rin67630/Sound-pressure-level-meter-Booster/1_VersionHistory.md

01.05.2022   Update following the breaking changes of ESP8266 compiler:
             BREAKING: Upgrade to upstream newlib 4.0.0 release (64 bits time_t) (#7708)
             BREAKING: httpclient: remove deprecated API (#7617)
