rin67630/Sound-pressure-level-meter-Booster/(threads)

Thread 1 (2025-02-23):

Fragen zum Projekt und Fehler beim kompilieren

vipersiytyseven, 2025-02-23:
Hallo.
Ich bin auf der Suche nach einer Möglichkeit Daten meines dB Messgeräts abzuspeichern und zu visualisieren und bin auf Ihre Webseite aufmerksam geworden.
Sehr umfangreich und auch sehr beeindruckend das Sie einem handeslüblichen dB Messgerät Daten entlocken können.
Mir würde es zwar in erster Linie reichen die Daten im lokalen Netz abzuspeichern und auszuwerten, aber ich sehe mir gerne mal die Möglichkeiten Ihrer Software an.

Entschuldigen Sie bitte meine geringen Kenntnisse in der Programmierung.
Trotz Ihrer sehr umfangreichen Dokumentation, werde ich leider nicht ganz schlau mit den Einstellungen und dem Kompilieren der Software.

Beispiel: Seite 20 des deutschsprachigen Dokuments.
Hier steht irgendetwas von A0 Parameter und Credentials.h
Die Credentials.h sieht ganz anders aus als in Ihrem Beispiel und eine A0 Parameter Registrierkarte kann ich auch nicht finden.

oder auch hier
zwei gleiche Einträge und welche Funktion hat der Raspberry Pi ?

#define UDP_TARGET          "192.168.?.?"         // Destination IP for your own Raspberry Pi
#define UDP_TARGET           "192.168.001.001"    // Destination IP for Raspberry Pi (enter real local IP)

Ein weiteres Beispiel: Das Kompilieren hat bei mir ebenfalls nicht funktioniert.
Ich bekomme eine Fehler:
Compilation error: 'GMT_OFFSET_SEC' was not declared in this scope
Ich verwende Arduino Version 2.3.4

Leider habe ich hier in github auch keine Möglichkeit gefunden direkt mit Ihnen Kontakt aufzunehmen. Das würde vieles einfacher mache. Gibt es da eine Möglichkeit ?

Für Ihre Rückmeldung herzlichen Dank im Voraus.

rin67630, 2025-03-30:
Es tut mir Leid, dass ich nicht geantwortet habe.
Ich habe einen Familienereignis und musste meine Projekte für eine Weile vernachlässigen.
Ich bin z.Zt  in Spanien.
Es gibt sehr viele Einstellungen im Projekt, die man nur in speziellen Situationen benötigt. UDP-Target ist eins davon...
Wenn es nicht besonders eilig ist (2-3 Monaten) kann ich eine Version aufbereiten, die man nicht kompilieren muss.
Es reicht dann einen Python Skript auszuführen, der die Anwenderdaten abfragt.

Was haben Sie als Messgerät, was möchten Sie programmieren?

vipersiytyseven, 2025-03-30:
Hallo und herzlichen Dank für Ihre freundliche Rückmeldung.

Zum Messgerät:
Ich besitze ein GM1358. Allerdings ist das Layout der Platine gegenüber den Bildern in Ihrer Dokumentation etwas geändert.
Der Anschluss eines ESP war aber problemlos möglich. Den ESP habe ich aktuell im Batteriefach untergebracht da ich in das Hauptgehäuse für die Tests kein Loch fräsen wollte. Es passt erstaunlich gut da rein. Ich überlege gerade, es dort zu belassen und den usb-Anschluß über einen angepassten Deckel rauszuführen.

Zum Test ob Daten vom Messgerät an den ESP übertragen werden bin ich in der Zwischenzeit einen kleinen Schritt weitergekommen. Ich habe ein kleines Skript gefunden, dass mir die Daten ausliest und auf einer vom ESP bereitgestellten Webseite ausgibt.
Die Werte entsprechen natürlich nicht den eigentlichen gemessenen Werten. Kommen denen aber recht nahe.
Somit scheint erstmal die Funktion der Übertragung von Daten zu funktionieren.

Zur Frage: Was möchte ich programmieren ?
Mein eigentliches Vorhaben war nicht die dauerhafte Messung sondern eine gezielte mobile Messung die sich auch über mehrere Stunden hinziehen kann. Die empfangenen Daten  sollten auch nicht online abgelegt werden sondern nur lokal ohne Zugriff aufs Internet z.B.  eine Netzwerkfreigabe oder offline z.B. an einem direkt angeschlossenem Raspberry Pi oder eine angeschlossene SD Karte.

Für die abgelegten Daten würde mir ein einfaches kommasepariertes Textformat (csv) reichen das in gewissen Zeitabständen die empfangenen Daten abspeichert. Diese können dann nach Beendigung der Messung ausgewertet , bzw. mit entsprechenden Tools in eine grafische Darstellung umgewandelt werden.

Beispiel für csv Format.
30.00,A,slow,2025-01-26 13:39:33
31.00,A,slow,2025-01-26 13:39:34

Soviel zu meinem eigentlichen Wunschgedanken.

Vielleicht ist dieses aber mit Ihrer Software möglich oder kann  entsprechend erweitert werden und ist sicherlich für den ein oder anderen Anwender Ihrer Software nützlich wenn dadurch keine externen Anbieter benötigt werden und es sich nur um mobile Messungen handelt.

Ich probiere natürlich gerne die kompilierte Version aus.

Viele Grüße und noch einen schönen Aufenthalt in Spanien.

rin67630, 2025-03-31:
Hallo,
mit der Config.h am Ende der Nachricht solltest Du eine Variante kompilieren, die die Ergebnisse auf der serielle Schnittstelle ausgibt.
Wenn UDP_IS_NONE, brauchst du die UDP Addresse und -Port nicht
Genauso wenn COM_IS_NONE...

Ersetzt Du TERM_IS_SERIAL  durch TERM_IS_TELNET, wird beim booten die Adresse des ESP-Geräts gemeldet.
Du kannst danach das ESP-Gerät über Telnet ansprechen, viel praktischer, als über serielle Schnittstelle.
Toi-Toi...

-----------------

Config.h
#define SCREEN_IS_NONE
#define SCREEN_IS_REVERSED    // _IS_NORMAL, _IS_REVERSED To turn the display 180° if required
#define BRIGHTNESS           128  // PWM value for default brightness with TTGO 0=totally dark;255=totally shiny

//----------------------- SOFTWARE OPTIONS ---------------------------------
#define DASHBRD_IS_NONE    // _NONE , _THINGER          // (Internet Dashboard)
#define GRACE_PAUSE           //Suspend Thinger processing for a grace pause, if the remote server takes too long to react, in order to keep being reactive on menues
//#define STREAM_DATA         //Stream data to Thinger (instead of letting Thinger fetch the data when viewed)
#define TERM_IS_SERIAL        // _TELNET, _SERIAL  defines where do Menus and Reports occur)
#define UDP_IS_NONE           // _NONE , _SEND , _RECEIVE  // (UDP Inter-ESP Communication)
#define ESP_UDP_ADDR         "192.168.188.12"              // (IP of the receiving ESP having BATTERY_SOURCE_IS_UDP)
#define ESP_UDP_PORT         4200                          // (Port used to send/receive Values to other ESP)
#define COM_IS_NONE          // _NONE , _HOURLY , _DAILY   // Periodical reports to computer
#define COM_UDP_ADDR         "192.168.188.12"              // (IP of the receiving computer for night reports)
#define COM_UDP_PORT         4230                          // (Port used to send/receive Values to other computer)
#define METER_TYPE           2                             // SPL Types = None (0), AK_Modulbus (1), GM1358 (2), Gravity (3), ZTS_ZS (4), reserve, reserve, Calibration (7)

//----------------------- MEASUREMENT AND I/O OPTIONS---------------------------------
#define WEATHER_SOURCE_IS_NONE   //_OWM _NONE _BME680             Change end accordingly
#define BATTERY_SOURCE_IS_NONE   // _UDP _NONE                    Change end accordingly
#define SOUND_SOURCE_IS_A0       //_A0 _URL _UDP _NONE _FOO _MODBUS     Change end accordingly
#define SP_METER_IS_GM1358       // _AK_MODULBUS, GM1358, _GRAVITY, _ZTS_ZS  Defined in Credentials

//   === Telnet communication
#define WIFI_REPEAT          500    //mS for retries and LED blinking during WiFi initialization
#define WIFI_MAXTRIES        30
#define WIFI_POWER           15     // from 0.5 to 21.5 full power (more current draw)
#define NTP_DELAY            6000
#define GRACE_PAUSE                //Suspend Network processing for a grace pause, if the remote server takes too long to react, in order to keep being reactive on menues

//   === Serial communication
#define SERIAL_SPEED            9600     //9600  115200 230400

// *** Default Personalization ***
#if __has_include("Credentials.h")
#include "Credentials.h"
#else  // Placeholders credentials to be used with https://github.com/rin67630/ESP_Binary_patcher
  #define DEVICE_NAME            "DEVCNAME                "  // Device name in local network and at thinger.io
  #define WIFI_SSID              "WIFISSID                "
  #define WIFI_PASS              "WIFIPASS                "
  #define SERVICE_PROVIDER       "CLOUDNAM                "  // http:// console.thinger.io
  #define CLOUD_USERNAME         "DEVCUSER                "  // User at thinger.io
  #define DEVICE_CREDENTIALS     "DEVCCRED                "  // Device credentials at thinger.io
  #define TZ_OFF                 "TZ_OFF  "                  // Offset to GMT in secs (exactly 8  chars incl spaces)
  #define DST_OFF                "DST_OFF "                  // Summer Offset in secs (exactly 8  chars incl spaces)
  #define LONGTD                 "LONGTD  "                  // Longitude             (exactly 8  chars incl spaces)
  #define LATITD                 "LATITD  "                  // Latitude              (exactly 8  chars incl spaces)
  #define OWMAPI         "OWMAPI                          "  // (exactly 32 chars incl spaces)

  // ***Event parameters***
  #define  WIND_LIMIT                  15 // upper limit of Wind speed to record NATs
  #define  UPPER_LIMIT_DB              88 // upper limit of Thinger plots
  #define  LOWER_LIMIT_DB              31 // lower limit of Thinger plots
  #define  EVENT_TRESHOLD_LEVEL       58 // Begin of Exceedance level
  #define  NAT_TRESHOLD_LEVEL         58 // Begin of Exceedance level
  #define  MEASUREMENT_THRESHOLD_LEVEL 55 // Begin of measurement level
  #define  MIN_EXCEEDANCE_TIME         10 // Minimum duration of an event
  #define  MAX_EXCEEDANCE_TIME         250 // Maximum duration of an event
  #define  LISTENING_TIME              20 // mimimum time between events
#endif

rin67630, 2025-03-31:
P.S. Du kannst ohne Credentials.h kompilieren, dann solltest Du in Config.h  die Platzhaltern zwischen Gänzefüßchen durch dine Werte ersetzen
#define DEVICE_NAME "DEVCNAME " // Device name in local network and at thinger.io
#define WIFI_SSID "WIFISSID "
#define WIFI_PASS "WIFIPASS "

vipersiytyseven, 2025-04-01:
Hallo und herzlichen Dank für die ausführlichen Informationen.
Ich werde das in den kommenden Wochen mal angehen.
Viele Grüße.
