rin67630/Sound-pressure-level-meter-Booster/Binaries/z_Thinger_Stats.h

{
	"description": "Summary Dashboard",
	"name": "Summary Dashboard",
	"properties": {
		"border_radius": "10px",
		"columns": 12,
		"row_height": 40,
		"show_template": true
	},
	"tabs": [
		{
			"icon": "fas fa-tachometer-alt",
			"name": "Summary Dashboard",
			"widgets": [
				{
					"layout": {
						"col": 0,
						"row": 12,
						"sizeX": 12,
						"sizeY": 2
					},
					"panel": {
						"color": "#ffffff",
						"currentColor": "#ffffff",
						"showOffline": {
							"type": "none"
						}
					},
					"properties": {
						"color": "#1E313E",
						"decimal_places": 2,
						"icon": "",
						"size": "50px",
						"unit_size": "20px",
						"weight": "font-thin"
					},
					"sources": [
						{
							"source": "value",
							"value": "Hourly Battery Charge Status"
						}
					],
					"type": "text"
				},
				{
					"layout": {
						"col": 0,
						"row": 6,
						"sizeX": 12,
						"sizeY": 2
					},
					"panel": {
						"color": "#ffffff"
					},
					"properties": {
						"color": "#1E313E",
						"decimal_places": 2,
						"icon": "",
						"size": "50px",
						"unit_size": "20px",
						"weight": "font-thin"
					},
					"sources": [
						{
							"source": "value",
							"value": "Hourly Lequ (Steady Noise Level Equivalent, ongoing)"
						}
					],
					"type": "text"
				},
				{
					"layout": {
						"col": 0,
						"row": 0,
						"sizeX": 12,
						"sizeY": 2
					},
					"panel": {
						"color": "#ffffff"
					},
					"properties": {
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
					},
					"properties": {
						"color": "#1E313E",
						"decimal_places": 0,
						"icon": "",
						"size": "25px",
						"unit_size": "20px",
						"weight": "font-thin"
					},
					"sources": [
						{
							"device_property": {
								"device": "DEVCNAME        ",
								"mapping": "NAT22-24",
								"property": "NATu",
								"user": "CLOUDNAM        "
							},
							"source": "device_property"
						}
					],
					"type": "text"
				},
				{
					"layout": {
						"col": 9,
						"row": 20,
						"sizeX": 1,
						"sizeY": 2
					},
					"panel": {
						"color": "#b7eaa2",
						"colors": [],
						"currentColor": "#b7eaa2",
						"showOffline": {
							"type": "none"
						},
						"subtitle": "",
						"title": "Battery voltage"
					},
					"properties": {
						"color": "#1E313E",
						"decimal_places": 2,
						"icon": "",
						"size": "25px",
						"unit": "v",
						"unit_size": "20px",
						"weight": "font-thin"
					},
					"sources": [
						{
							"device": {
								"id": "BluSCC",
								"interval": 60,
								"mapping": "BatV",
								"resource": "measure",
								"update": "interval"
							},
							"device_property": {
								"device": "BluSCC",
								"mapping": "voltageDelta",
								"property": "persistance",
								"user": "CLOUDNAM        "
							},
							"source": "device"
						}
					],
					"type": "text"
				},
				{
					"layout": {
						"col": 6,
						"row": 10,
						"sizeX": 1,
						"sizeY": 2
					},
					"panel": {
						"color": "#dfe9f7",
						"title": "18h"
					},
					"properties": {
						"color": "#1E313E",
						"decimal_places": 2,
						"icon": "",
						"size": "25px",
						"unit": "dB",
						"unit_size": "20px",
						"weight": "font-thin"
					},
					"sources": [
						{
							"device_property": {
								"device": "DEVCNAME        ",
								"mapping": "18h",
								"property": "lequ",
								"user": "CLOUDNAM        "
							},
							"source": "device_property"
						}
					],
					"type": "text"
				},
				{
					"layout": {
						"col": 4,
						"row": 20,
						"sizeX": 1,
						"sizeY": 2
					},
					"panel": {
						"color": "#dfe9f7",
						"title": "Leq Day (24h)"
					},
					"properties": {
						"color": "#1E313E",
						"decimal_places": 2,
						"icon": "",
						"size": "25px",
						"unit": "dB",
						"unit_size": "20px",
						"weight": "font-thin"
					},
					"sources": [
						{
							"device_property": {
								"device": "DEVCNAME        ",
								"mapping": "Day",
								"property": "lequ",
								"user": "CLOUDNAM        "
							},
							"source": "device_property"
						}
					],
					"type": "text"
				},
				{
					"layout": {
						"col": 0,
						"row": 20,
						"sizeX": 1,
						"sizeY": 2
					},
					"panel": {
						"color": "#dfe9f7",
						"title": "Leq Daytime"
					},
					"properties": {
						"color": "#1E313E",
						"decimal_places": 2,
						"icon": "",
						"size": "25px",
						"unit": "dB",
						"unit_size": "20px",
						"weight": "font-thin"
					},
					"sources": [
						{
							"device_property": {
								"device": "DEVCNAME        ",
								"mapping": "Daytime",
								"property": "lequ",
								"user": "CLOUDNAM        "
							},
							"source": "device_property"
						}
					],
					"type": "text"
				},
				{
					"layout": {
						"col": 1,
						"row": 20,
						"sizeX": 1,
						"sizeY": 2
					},
					"panel": {
						"color": "#8db0e2",
						"title": "Leq Nighttime"
					},
					"properties": {
						"color": "#1E313E",
						"decimal_places": 2,
						"icon": "",
						"size": "25px",
						"unit": "dB",
						"unit_size": "20px",
						"weight": "font-thin"
					},
					"sources": [
						{
							"device_property": {
								"device": "DEVCNAME        ",
								"mapping": "Nighttime",
								"property": "lequ",
								"user": "CLOUDNAM        "
							},
							"source": "device_property"
						}
					],
					"type": "text"
				},
				{
					"layout": {
						"col": 2,
						"row": 20,
						"sizeX": 1,
						"sizeY": 2
					},
					"panel": {
						"color": "#8db0e2",
						"title": "Leq 22-24h"
					},
					"properties": {
						"color": "#1E313E",
						"decimal_places": 2,
						"icon": "",
						"size": "25px",
						"unit": "dB",
						"unit_size": "20px",
						"weight": "font-thin"
					},
					"sources": [
						{
							"device_property": {
								"device": "DEVCNAME        ",
								"mapping": "L22-24h",
								"property": "lequ",
								"user": "CLOUDNAM        "
							},
							"source": "device_property"
						}
					],
					"type": "text"
				},
				{
					"layout": {
						"col": 6,
						"row": 2,
						"sizeX": 1,
						"sizeY": 2
					},
					"panel": {
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
				},
				"source": "device_property"
			},
			"layout": {
				"col": 11,
				"row": 20,
				"sizeX": 1,
				"sizeY": 2
			},
			"panel": {
				"color": "#dfe9f7",
				"title": "Bat Yesterdy"
			},
			"properties": {
				"color": "#1E313E",
				"decimal_places": 2,
				"icon": "",
				"size": "25px",
				"unit": "Ah",
				"unit_size": "20px",
				"weight": "font-thin"
			},
			"type": "text"
		}
	],
	"placeholders": {
		"sources": []
	}
}
