rin67630/Sound-pressure-level-meter-Booster/Software/b_Functions.ino

// Macro for Timing
#define runEvery(t) for (static uint16_t _lasttime;\
                         (uint16_t)((uint16_t)millis() - _lasttime) >= (t);\
                         _lasttime += (t))

// Instantiate classes
WiFiUDP    UDP;
#if defined(BATTERY_SOURCE_IS_INA)
INA_Class  INA;
#endif
WiFiClient WifiClient;
HTTPClient http;

#if defined (THINGER)
ThingerESP8266 thing(THINGER_USERNAME, THINGER_DEVICE, THINGER_CREDENTIALS);
#endif

// Functions

// WiFi Managemement
void getWiFi()              // From Memory , Using Defaults, or using SmartConfig
{
  int retry = 0;
  WiFi.mode(WIFI_STA);      // configure WiFi in Station Mode
  wifi_station_set_hostname(HOST_NAME);
  wifi_station_set_auto_connect(true);
  delay(wifiRepeatInterval);
  Console3.println("Attempt to connect to WiFi network from EEPROM");
  WiFi.begin();
  delay(wifiRepeatInterval);
  while (WiFi.status() != WL_CONNECTED)
  {
    Console3.print(".");
    digitalWrite(STDLED, not digitalRead(STDLED));
    delay(wifiRepeatInterval) ;
    if (retry++ >= wifiMaxTries) break;
  }

  if (WiFi.status() != WL_CONNECTED)
  {
    Console3.println("\nConnection timeout expired! Start with default");
    retry = 0;
    WiFi.begin(WIFI_SSID, WIFI_PASS);
    delay(wifiRepeatInterval * 2 );
    while (WiFi.status() != WL_CONNECTED)
    {
      Console3.print(".");
      digitalWrite(STDLED, not digitalRead(STDLED));
      delay(wifiRepeatInterval);
      if (retry++ >= wifiMaxTries) break;
    }
  }
  if (WiFi.status() != WL_CONNECTED)
  {
    Console3.println("Connection timeout expired! Start SmartConfig…");
    retry = 0;
    WiFi.beginSmartConfig();
    digitalWrite(STDLED, false);
    while (WiFi.status() != WL_CONNECTED)
    {
      Console3.print(".");
      digitalWrite(STDLED, not digitalRead(STDLED));
      delay(wifiRepeatInterval * 4);
      if (retry++ >= wifiMaxTries) break;
      if (WiFi.smartConfigDone())
      {
        Console3.println("SmartConfig success!");
        break; // exit from loop
      }
    }
  }
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
