rin67630/Sound-pressure-level-meter-Booster/(commit log)

2020-08-28 Update e_Data.ino
    Redefinition of httpCode prevented
    forgotten curly brace pair at line 355+380 retrofitted:
    -it called weather uninterrupted, shame on me!
    [blush]
    [e_Data.ino]
2020-09-11 Update e_Data.ino
    improved battery evaluation
2020-09-11 Update e_Data.ino
    Corrected Leq math at the end of the day.
    [e_Data.ino]
2020-09-19 Update e_Data.ino
    Correction on event processing
    [e_Data.ino]
2024-03-14 Update Credentials.h
    Added settings for Gravity SPL sensor.
